littleboot/ACRE/Firmware/Doc/readme.txt

Firmware fot the Absolute Capacitive Rotary Encoder (ACRE).
