littleboot/ACRE/docs/images/capacitors_plates_figure.png

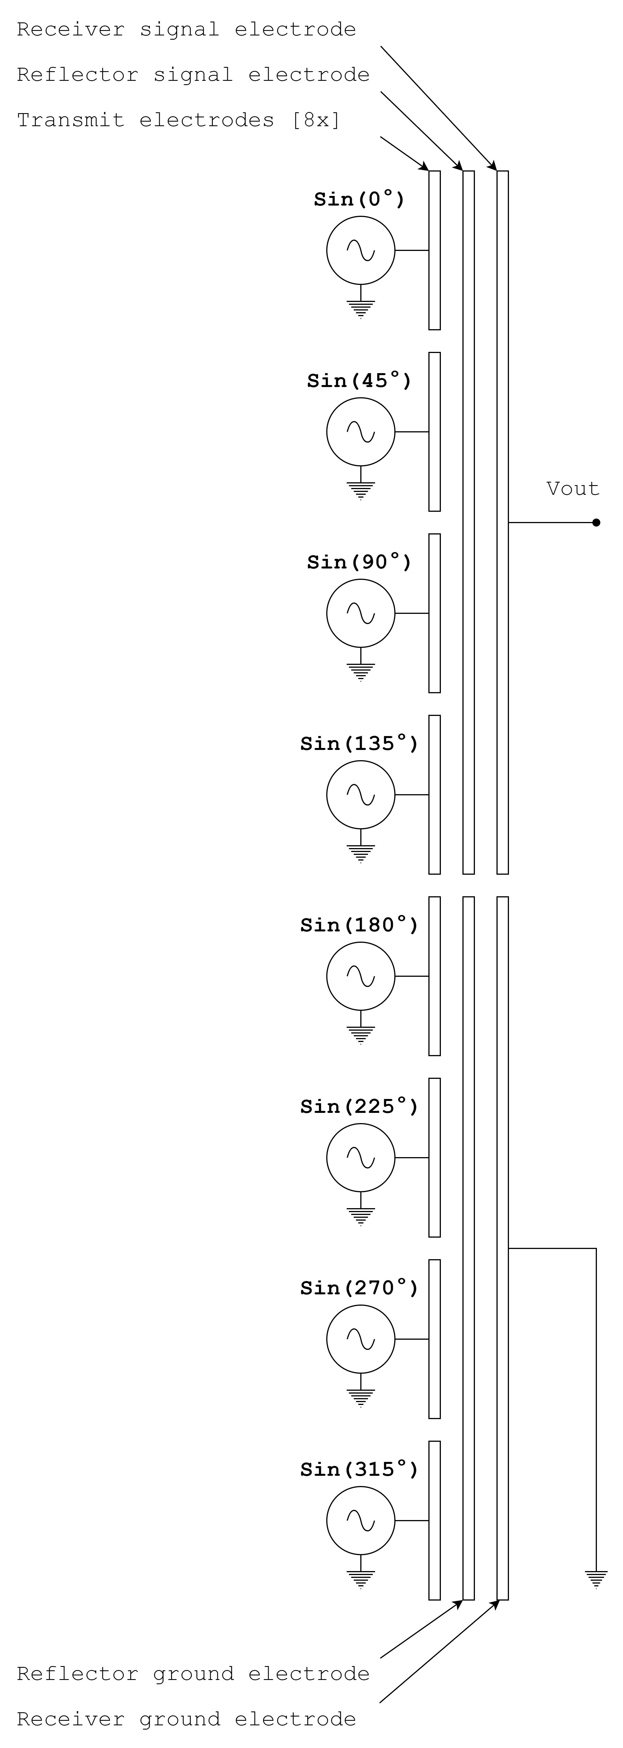
docs/images/capacitors_plates_figure.png
