littleboot/ACRE/docs/images/gif_animation_sources/1.png

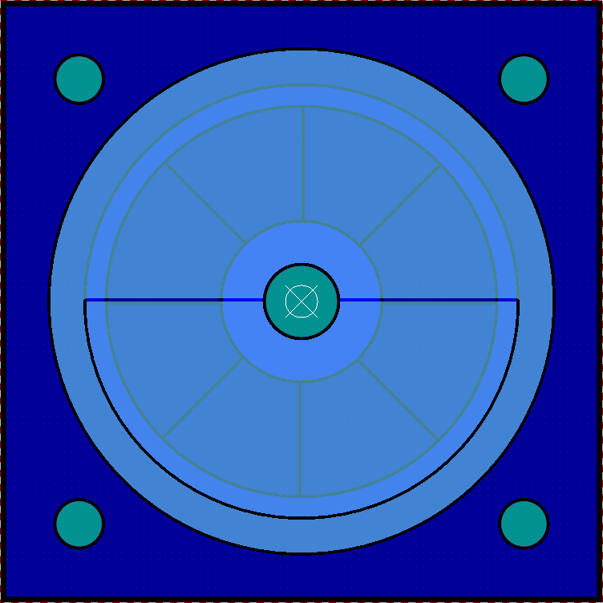
docs/images/gif_animation_sources/1.png
