littleboot/ACRE/docs/images/gif_animation_sources/3.png

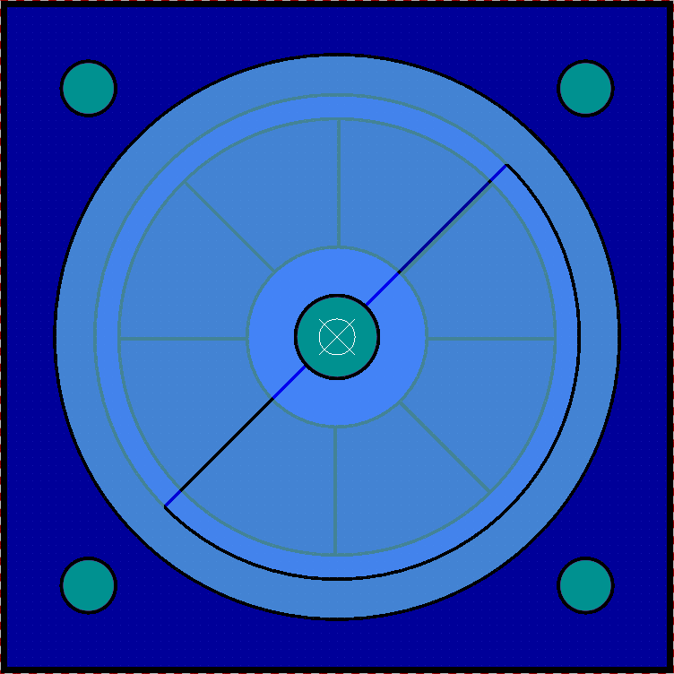
docs/images/gif_animation_sources/3.png
