littleboot/ACRE/docs/images/gif_animation_sources/4.png

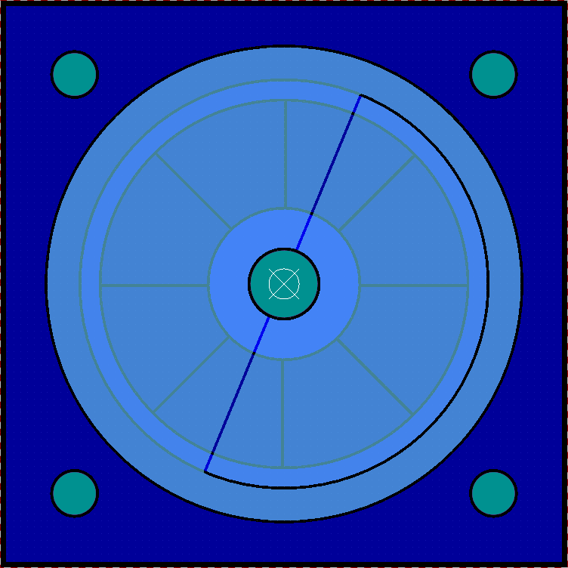
docs/images/gif_animation_sources/4.png
