littleboot/ACRE/docs/images/gif_animation_sources/5.png

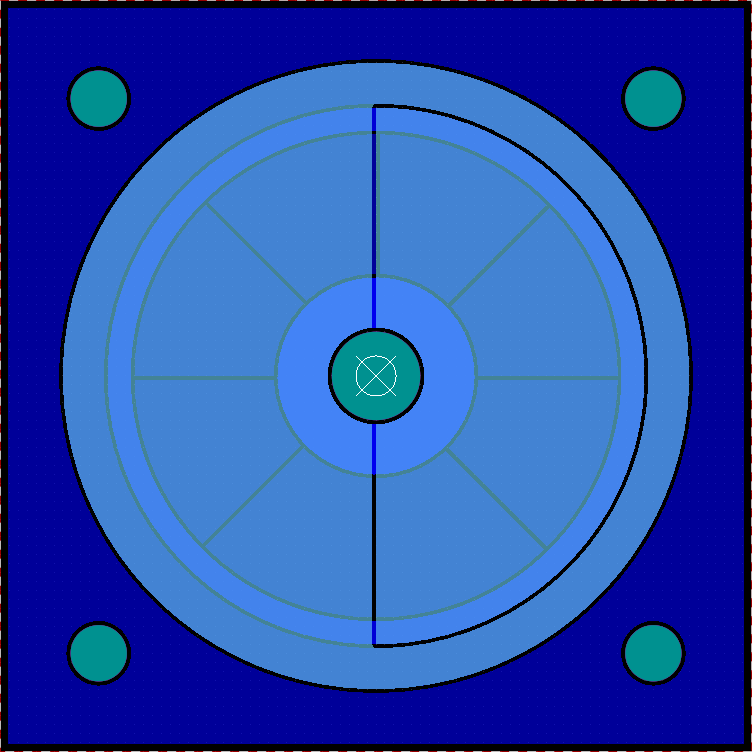
docs/images/gif_animation_sources/5.png
