littleboot/ACRE/docs/images/gif_animation_sources/6.png

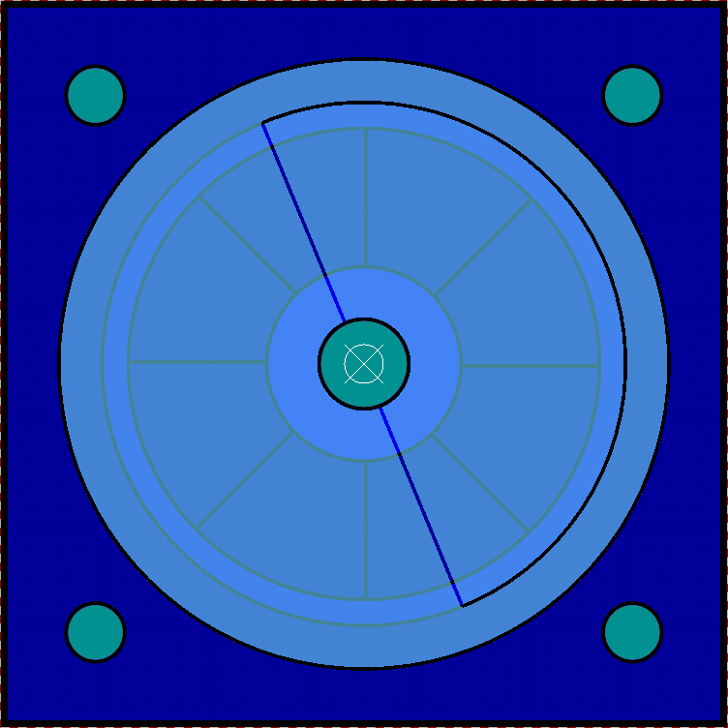
docs/images/gif_animation_sources/6.png
