littleboot/ACRE/docs/images/gif_animation_sources/7.png

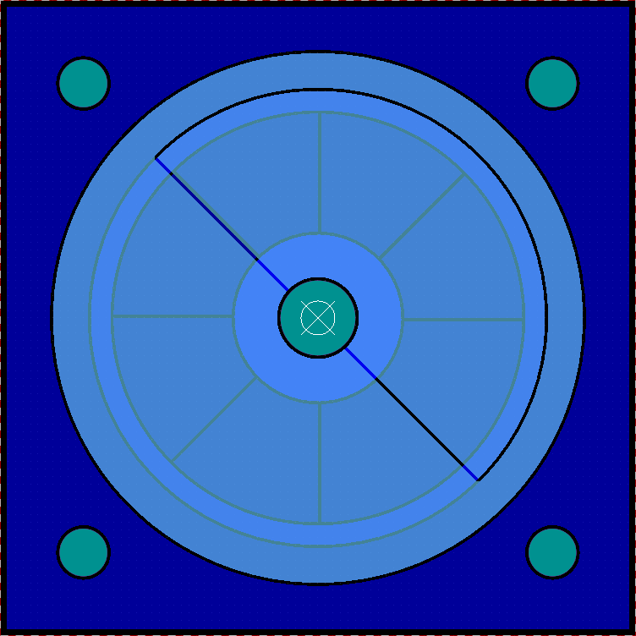
docs/images/gif_animation_sources/7.png
