littleboot/ACRE/docs/images/gif_animation_sources/9.png

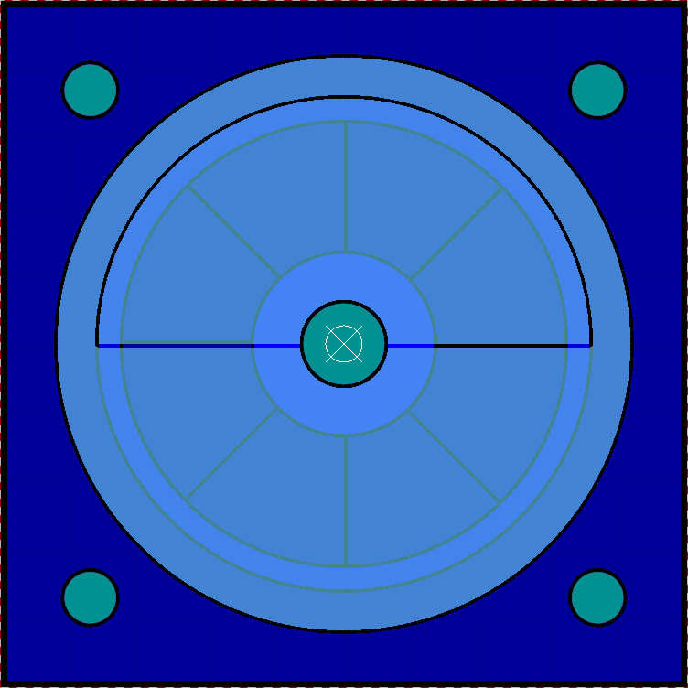
docs/images/gif_animation_sources/9.png
