littleboot/ACRE/docs/images/gif_animation_sources/12.png

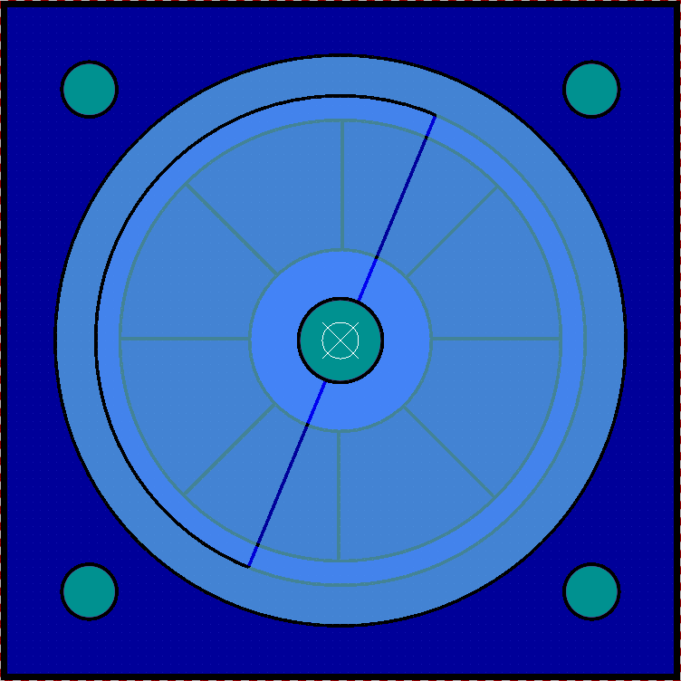
docs/images/gif_animation_sources/12.png
