littleboot/ACRE/docs/images/gif_animation_sources/13.png

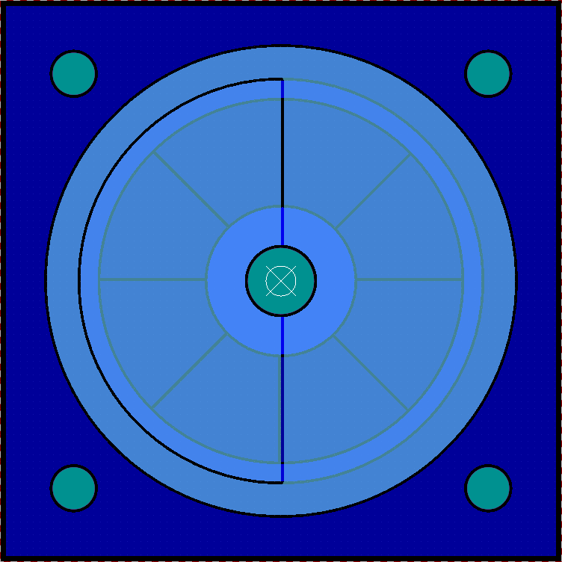
docs/images/gif_animation_sources/13.png
