littleboot/ACRE/docs/images/gif_animation_sources/14.png

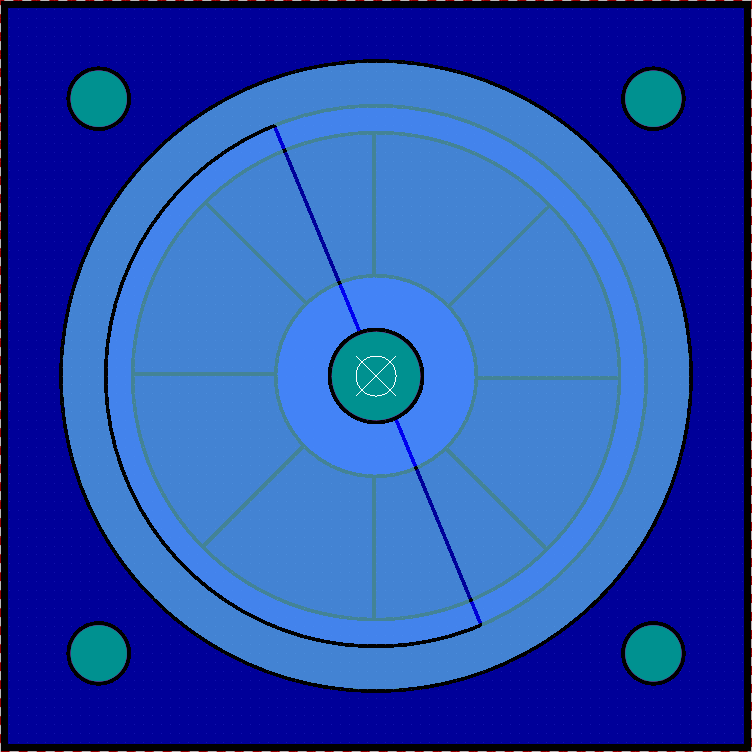
docs/images/gif_animation_sources/14.png
