littleboot/ACRE/docs/images/gif_animation_sources/a1.png

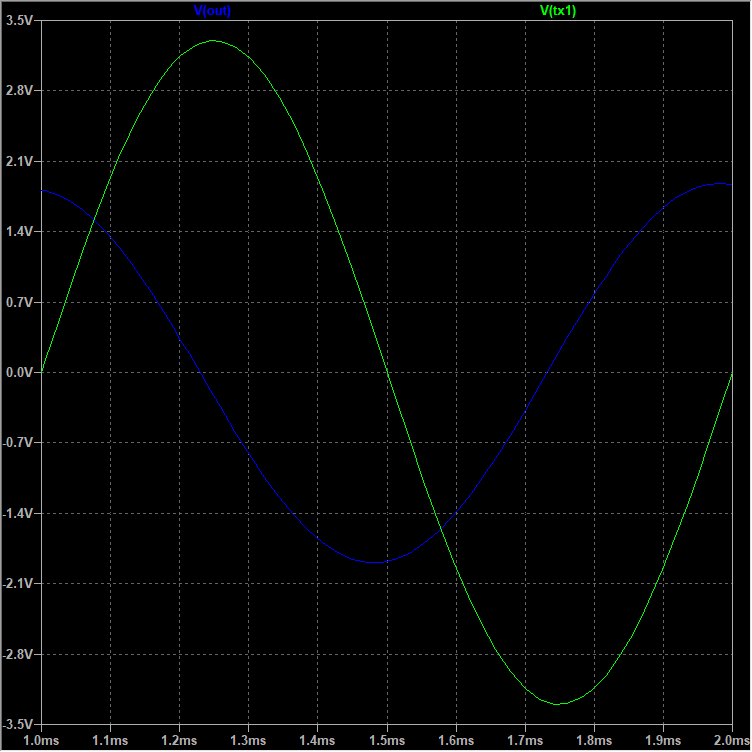
docs/images/gif_animation_sources/a1.png
