littleboot/ACRE/docs/images/gif_animation_sources/a7.png

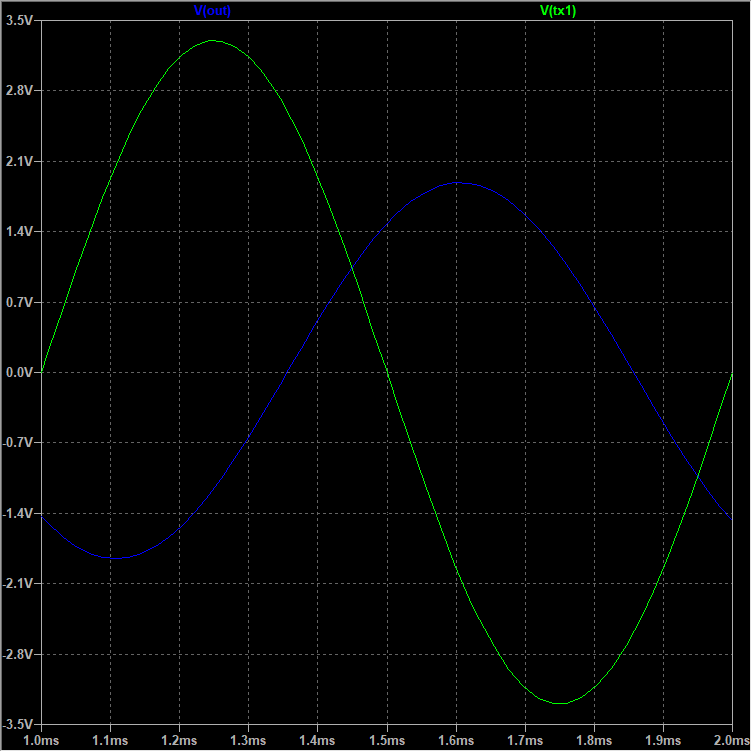
docs/images/gif_animation_sources/a7.png
