littleboot/ACRE/docs/images/gif_animation_sources/a15.png

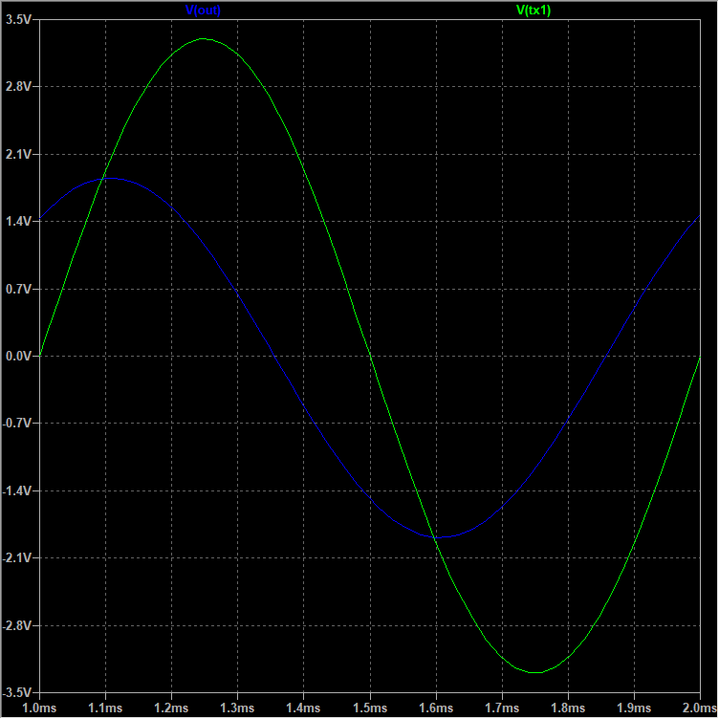
docs/images/gif_animation_sources/a15.png
