littleboot/ACRE/docs/images/gif_animation_sources/b5.png

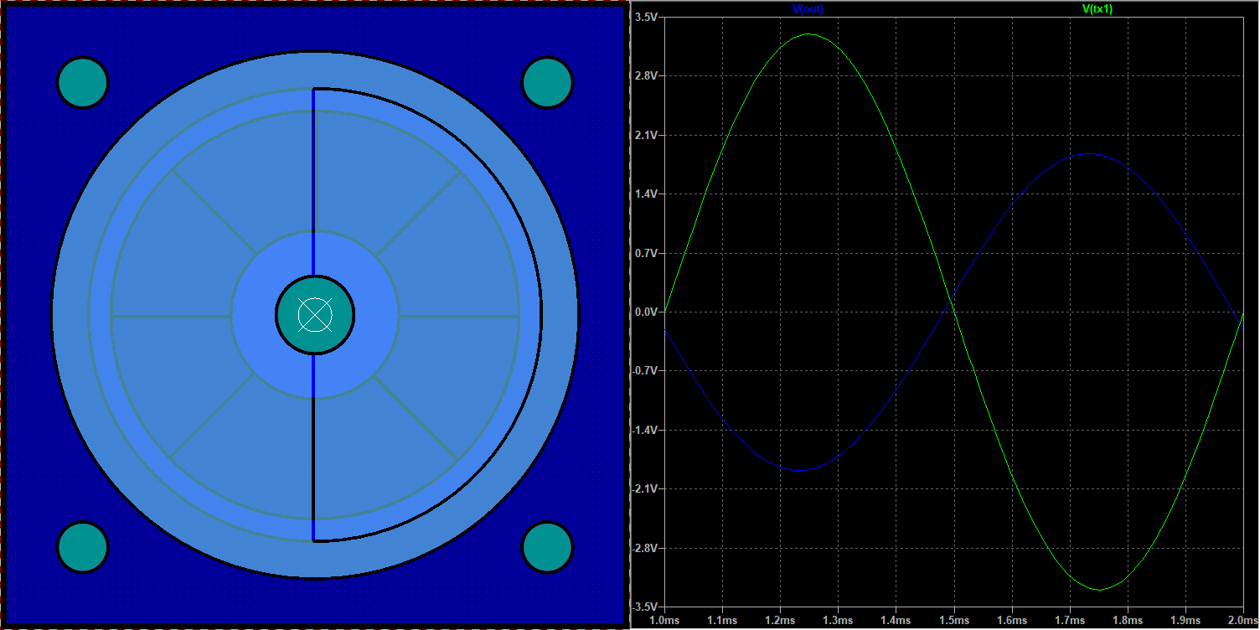
docs/images/gif_animation_sources/b5.png
