littleboot/ACRE/docs/images/Scope_signals01.png

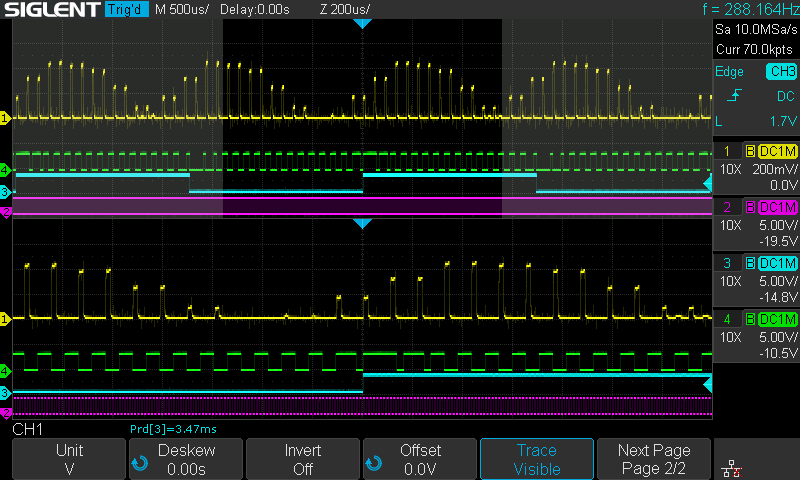
docs/images/Scope_signals01.png
