littleboot/ACRE/docs/images/sine_addition_SPICE_plot.png

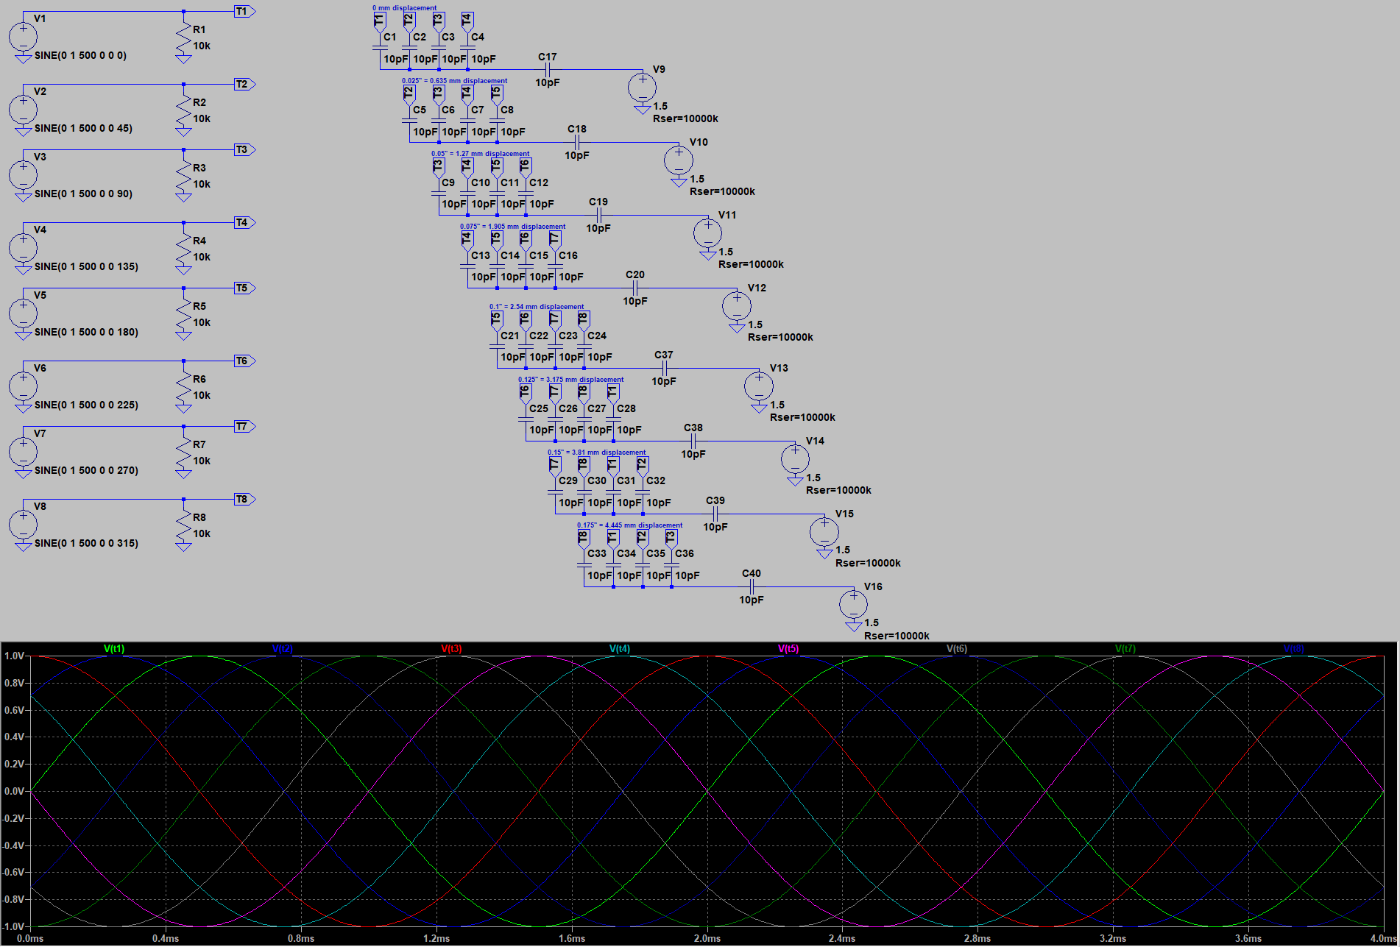
docs/images/sine_addition_SPICE_plot.png
