littleboot/ACRE/Hardware/Electrical/T211110V01/_Ordered/Readme.txt

This folder contains fabrication files and BOM's that have been ordered in the past
