littleboot/ACRE/Hardware/Electrical/T211110V01/_Ordered/T211110V01 2021-11-16/Documentation - T211110V01 2021-11-16/BOM - T211110V01 2021-11-16  23-40.xlsx

Sheet: BOM - T211110V01 2021-11-16 23
Designator | Comment | Description | Part Number | Manufacturer | Footprint | Supplier 1 | Supplier Part Number 1 | Supplier 2 | Supplier Part Number 2 | Supplier 3 | Supplier Part Number 3 | Quantity
C1, C3, C22 | 10uF | 10uF ±10% 25V X5R 1206 Multilayer Ceramic Capacitors MLCC - SMD/SMT RoHS | CL31A106KAHNNNE | SAMSUNG | CAP 1206 3216 IPC MEDIUM | LCSC | C9807 | Farnell | 3013511 | Mouser | 187-CL31A106KAHNNNE | 3 | 15
C2, C4, C7, C11, C12, C14, C16, C21, C23, C26 | 100nF | 100nF ±10% 50V X7R 0603 Multilayer Ceramic Capacitors MLCC - SMD/SMT RoHS | C0603B104K500NT | TORCH | CAP 0603 1608 IPC MEDIUM | LCSC | C478888 |  |  |  |  | 10 | 50
C5, C8 | 1uF | Generic 0603 1608 Capacitor | CGA3E1X7R1C105M080AC | TDK | CAP 0603 1608 IPC MEDIUM | Farnell | 2768390 |  |  |  |  | 2 | 10
C6, C13 | 4.7uF | 4.7 µF, 25 V, 0603 [1608 Metric], ± 10%, X5R, GRM Series | GRM188R61E475KE11D | MURATA | CAP 0603 1608 IPC MEDIUM | Farnell | 2426959 |  |  |  |  | 2 | 10
C9 | 10nF | Generic 0603 1608 Capacitor | x |  | CAP 0603 1608 IPC MEDIUM | Farnell | 2495178 |  |  |  |  | 1 | 5
C10, C15 | open | Capacitor 0603 1608 value undefined | x |  | CAP 0603 1608 IPC MEDIUM |  |  |  |  |  |  | 2 | 10
C17, C18, C19, C20 | 12pF | 12pF ±5% 50V NP0 0603 Multilayer Ceramic Capacitors MLCC - SMD/SMT RoHS | CC0603JRNPO9BN120 | YAGEO | CAP 0603 1608 IPC MEDIUM | LCSC | C107034 | Farnell | 721979 | Mouser | 603-CC603JRNPO9BN120 | 4 | 20
C24, C25 | 330pF | Generic 0603 1608 Capacitor | CL10C331JB8NNNC | SAMSUNG | CAP 0603 1608 IPC MEDIUM | LCSC | C1664 | Mouser | 187-CL10C331JB8NNNC | Digikey | 1276-1073-1-ND | 2 | 10
C27 | 47pF | Generic 0603 1608 Capacitor | x |  | CAP 0603 1608 IPC MEDIUM |  |  |  |  |  |  | 1 | 5
D1, D2, D3 | 19-217/R6C-AL1M2VY/3T | Red 617.5~633.5nm 0603 Light Emitting Diodes (LED) RoHS | 19-217/R6C-AL1M2VY/3T | EVERLIGHT | 19-217 - EVERLIGHT | LCSC | C72044 |  |  |  |  | 3 | 15
D4 | RCLAMP0524P-N | TVS ARRAY, 40W, 5V, UNIDIRECTIONAL, USB, HDMI | RCLAMP0524P-N | BORN | RCLAMP0524P-N - BORN | LCSC | C316044 |  |  |  |  | 1 | 5
FB1 | 600 E @ 100 MHz | Ferrite Bead, 0603 [1608 Metric], 600 ohm, 500 mA, BLM18A Series, 0.38 ohm, ± 25% | BLM18AG601SN1D | MURATA | FB 0603 1608 IPC MEDIUM - Murata | Farnell | 1515679 | Mouser | 81-BLM11A601S | LCSC | C19330 | 1 | 5
J1 | TYPE-C-31-M-12 | USB - Type C Female 12-pin | TYPE-C-31-M-12 | HRO ELECTRONICS | TYPE-C-31-M-12 - KOREAN HROPARTS ELEC | LCSC | C165948 |  |  |  |  | 1 | 5
Q1 | 2N7002AK | Power MOSFET, N Channel, 60 V, 190 mA, 3 ohm, SOT-23 TO-236AB | 2N7002AK | NEXPERIA | SOT23-3 IPC MEDIUM - NEXPERIA | Farnell | 2191746 | Mouser | 771-NX7002AK,215 | LCSC | C255584 | 1 | 5
R1, R2, R3, R5 | 1K | 1kΩ ±1% 0.1W ±100ppm/℃ 0603 Chip Resistor - Surface Mount RoHS | RC0603FR-071KL | YAGEO | RES 0603 1608 IPC MEDIUM | LCSC | C22548 | Farnell | 2421849 | Mouser | 603-RC0603FR-071KL | 4 | 20
R4 | 2K | 2kΩ ±1% 0.1W 0603 Chip Resistor - Surface Mount RoHS | RMC06032K1%N | TOYOHM | RES 0603 1608 IPC MEDIUM | LCSC | C269421 |  |  |  |  | 1 | 5
R6 | 47K | 47kΩ ±1% 100mW ±100ppm/℃ Thick Film Resistors 75V -55℃~+155℃ 0603 Chip Resistor - Surface Mount RoHS | RC0603FR-0747KL | YAGEO | RES 0603 1608 IPC MEDIUM | LCSC | C105579 | Farnell | 2421877 | Mouser | 603-RC0603FR-0747KL | 1 | 5
R7, R8, R9, R10 | 10K | 10kΩ ±1% 0.1W ±100ppm/℃ 0603 Chip Resistor - Surface Mount RoHS | RC0603FR-0710KL | YAGEO | RES 0603 1608 IPC MEDIUM | LCSC | C98220 | Farnell | 2421850 | Digikey | 311-10.0KHRCT-ND | 4 | 20
R11, R12, R16 | 100E | 100Ω ±1.0% 1/10W ±100ppm/℃ Thick Film Resistors 75V -55℃~+155℃ 0603 Chip Resistor - Surface Mount RoHS | RC0603FR-07100RL | YAGEO | RES 0603 1608 IPC MEDIUM | LCSC | C105588 | Farnell | 2421848 | Mouser | 603-RC0603FR-07100RL | 3 | 15
R13, R14 | 5.1K | 5.1kΩ ±1% 0.1W 0603 Chip Resistor - Surface Mount RoHS | RMC06035.1K1%N | TYOHM | RES 0603 1608 IPC MEDIUM | LCSC | C269716 |  |  |  |  | 2 | 10
R15 | 0E | 0Ω ±1.0% 1/10W Thick Film Resistors 75V -55℃~+155℃ 0603 Chip Resistor - Surface Mount RoHS | RC0603FR-070RL | YAGEO | RES 0603 1608 IPC MEDIUM | LCSC | C100044 | Farnell | 2309106 | Mouser | 603-RC0603FR-070RL | 1 | 5
U1 | AMS1117-3.3 | LDO 3.3V 1A 18V | AMS1117-3.3 | UMW | SOT223 IPC MEDIUM - UMW | LCSC | C347222 |  |  |  |  | 1 | 5
U2 | MCP6001T-I/OT | Operational Amplifier, Single, 1 Amplifier, 1 MHz, 0.6 V/µs, 1.8V to 6V, SOT-23, 5 Pins | MCP6001T-I/OT | MICROCHIP | SOT23-5 IPC MEDIUM - MICROCHIP | Farnell | 4974992 | LCSC | C116490 | - |  | 1 | 5
U3 | STM32F103C8T6 | ARM Microcontroller, Motor Control, STM32 Family STM32F1 Series Microcontrollers, ARM Cortex-M3 | STM32F103C8T6 | STMICROELECTRONICS | LQFP48 IPC MEDIUM - STMICROELECTRONICS | Farnell | 1447637 | Mouser | 511-STM32F103C8T6 | LCSC | C8734 | 1 | 5
U4 | 74HC1G66GV | Analogue Switch, SPST, 1 Channels, 50 ohm, 2V to 9V, TSOP, 5 Pins | 74HC1G66GV | NEXPERIA | SOT753 IPC MEDIUM - NEXPERIA | LCSC | 74HC1G66GV | Farnell | 2777726 | Mouser | 771-HC1G66GV125 | 1 | 5
U5 | CH340T | USB to UART Bridge Controller USB 2.0 Full speed 50bps to 2Mbps | CH340T | WCH | CH340T - WCH | LCSC | C8689 |  |  |  |  | 1 | 5
X1, X2 | X322512MLB4SI | 12MHz ±10ppm 9pF 80Ω SMD-3225_4P Crystals RoHS | X322512MLB4SI | YXC | X322512MLB4SI - YXC | LCSC | C112971 |  |  |  |  | 2 | 10

Sheet: LCSC Order 5pcs
Designator | Comment | Description | Part Number | Manufacturer | Footprint | Supplier 1 | Supplier Part Number 1 | Supplier 2 | Supplier Part Number 2 | Supplier 3 | Supplier Part Number 3
C1, C3, C22 | 10uF | 10uF ±10% 25V X5R 1206 Multilayer Ceramic Capacitors MLCC - SMD/SMT RoHS | CL31A106KAHNNNE | SAMSUNG | CAP 1206 3216 IPC MEDIUM | LCSC | C9807 | Farnell | 3013511 | Mouser | 187-CL31A106KAHNNNE | 15
C2, C4, C7, C11, C12, C14, C16, C21, C23, C26 | 100nF | 100nF ±10% 50V X7R 0603 Multilayer Ceramic Capacitors MLCC - SMD/SMT RoHS | C0603B104K500NT | TORCH | CAP 0603 1608 IPC MEDIUM | LCSC | C478888 |  |  |  |  | 50
C5, C8 | 1uF | Generic 0603 1608 Capacitor | CGA3E1X7R1C105M080AC | TDK | CAP 0603 1608 IPC MEDIUM | Farnell | 2768390 | LCSC | C1592 |  |  | 10
C6, C13 | 4.7uF | 4.7 µF, 25 V, 0603 [1608 Metric], ± 10%, X5R, GRM Series | GRM188R61E475KE11D | MURATA | CAP 0603 1608 IPC MEDIUM | Farnell | 2426959 | LCSC | C8032 |  |  | 10
C9 | 10nF | Generic 0603 1608 Capacitor | x |  | CAP 0603 1608 IPC MEDIUM | Farnell | 2495178 | LCSC | C100042 |  |  | 5
C10, C15 | open | Capacitor 0603 1608 value undefined | x |  | CAP 0603 1608 IPC MEDIUM |  |  |  |  |  |  | 0
C17, C18, C19, C20 | 12pF | 12pF ±5% 50V NP0 0603 Multilayer Ceramic Capacitors MLCC - SMD/SMT RoHS | CC0603JRNPO9BN120 | YAGEO | CAP 0603 1608 IPC MEDIUM | LCSC | C107034 | Farnell | 721979 | Mouser | 603-CC603JRNPO9BN120 | 20
C24, C25 | 330pF | Generic 0603 1608 Capacitor | CL10C331JB8NNNC | SAMSUNG | CAP 0603 1608 IPC MEDIUM | LCSC | C1664 | Mouser | 187-CL10C331JB8NNNC | Digikey | 1276-1073-1-ND | 10
C27 | 47pF | Generic 0603 1608 Capacitor | x |  | CAP 0603 1608 IPC MEDIUM | LCSC | C105622 |  |  |  |  | 5
D1, D2, D3 | 19-217/R6C-AL1M2VY/3T | Red 617.5~633.5nm 0603 Light Emitting Diodes (LED) RoHS | 19-217/R6C-AL1M2VY/3T | EVERLIGHT | 19-217 - EVERLIGHT | LCSC | C72044 |  |  |  |  | 15
D4 | RCLAMP0524P-N | TVS ARRAY, 40W, 5V, UNIDIRECTIONAL, USB, HDMI | RCLAMP0524P-N | BORN | RCLAMP0524P-N - BORN | LCSC | C316044 |  |  |  |  | 5
FB1 | 600 E @ 100 MHz | Ferrite Bead, 0603 [1608 Metric], 600 ohm, 500 mA, BLM18A Series, 0.38 ohm, ± 25% | BLM18AG601SN1D | MURATA | FB 0603 1608 IPC MEDIUM - Murata | Farnell | 1515679 | Mouser | 81-BLM11A601S | LCSC | C19330 | 5
J1 | TYPE-C-31-M-12 | USB - Type C Female 12-pin | TYPE-C-31-M-12 | HRO ELECTRONICS | TYPE-C-31-M-12 - KOREAN HROPARTS ELEC | LCSC | C165948 |  |  |  |  | 5
Q1 | 2N7002AK | Power MOSFET, N Channel, 60 V, 190 mA, 3 ohm, SOT-23 TO-236AB | 2N7002AK | NEXPERIA | SOT23-3 IPC MEDIUM - NEXPERIA | Farnell | 2191746 | Mouser | 771-NX7002AK,215 | LCSC | C255584 | 5
R1, R2, R3, R5 | 1K | 1kΩ ±1% 0.1W ±100ppm/℃ 0603 Chip Resistor - Surface Mount RoHS | RC0603FR-071KL | YAGEO | RES 0603 1608 IPC MEDIUM | LCSC | C22548 | Farnell | 2421849 | Mouser | 603-RC0603FR-071KL | 20
R4 | 2K | 2kΩ ±1% 0.1W 0603 Chip Resistor - Surface Mount RoHS | RMC06032K1%N | TOYOHM | RES 0603 1608 IPC MEDIUM | LCSC | C269421 |  |  |  |  | 5
R6 | 47K | 47kΩ ±1% 100mW ±100ppm/℃ Thick Film Resistors 75V -55℃~+155℃ 0603 Chip Resistor - Surface Mount RoHS | RC0603FR-0747KL | YAGEO | RES 0603 1608 IPC MEDIUM | LCSC | C105579 | Farnell | 2421877 | Mouser | 603-RC0603FR-0747KL | 5 | *replaced by 10K
R7, R8, R9, R10 | 10K | 10kΩ ±1% 0.1W ±100ppm/℃ 0603 Chip Resistor - Surface Mount RoHS | RC0603FR-0710KL | YAGEO | RES 0603 1608 IPC MEDIUM | LCSC | C98220 | Farnell | 2421850 | Digikey | 311-10.0KHRCT-ND | 20
R11, R12, R16 | 100E | 100Ω ±1.0% 1/10W ±100ppm/℃ Thick Film Resistors 75V -55℃~+155℃ 0603 Chip Resistor - Surface Mount RoHS | RC0603FR-07100RL | YAGEO | RES 0603 1608 IPC MEDIUM | LCSC | C105588 | Farnell | 2421848 | Mouser | 603-RC0603FR-07100RL | 15
R13, R14 | 5.1K | 5.1kΩ ±1% 0.1W 0603 Chip Resistor - Surface Mount RoHS | RMC06035.1K1%N | TYOHM | RES 0603 1608 IPC MEDIUM | LCSC | C269716 |  |  |  |  | 10
R15 | 0E | 0Ω ±1.0% 1/10W Thick Film Resistors 75V -55℃~+155℃ 0603 Chip Resistor - Surface Mount RoHS | RC0603FR-070RL | YAGEO | RES 0603 1608 IPC MEDIUM | LCSC | C100044 | Farnell | 2309106 | Mouser | 603-RC0603FR-070RL | 5
U1 | AMS1117-3.3 | LDO 3.3V 1A 18V | AMS1117-3.3 | UMW | SOT223 IPC MEDIUM - UMW | LCSC | C347222 |  |  |  |  | 5
U2 | MCP6001T-I/OT | Operational Amplifier, Single, 1 Amplifier, 1 MHz, 0.6 V/µs, 1.8V to 6V, SOT-23, 5 Pins | MCP6001T-I/OT | MICROCHIP | SOT23-5 IPC MEDIUM - MICROCHIP | Farnell | 4974992 | LCSC | C116490 | - |  | 5
U3 | STM32F103C8T6 | ARM Microcontroller, Motor Control, STM32 Family STM32F1 Series Microcontrollers, ARM Cortex-M3 | STM32F103C8T6 | STMICROELECTRONICS | LQFP48 IPC MEDIUM - STMICROELECTRONICS | Farnell | 1447637 | Mouser | 511-STM32F103C8T6 | LCSC | C8734 | 5 | Ordered 1 stm32 and rest Gigadevice alternatives
U4 | 74HC1G66GV | Analogue Switch, SPST, 1 Channels, 50 ohm, 2V to 9V, TSOP, 5 Pins | 74HC1G66GV | NEXPERIA | SOT753 IPC MEDIUM - NEXPERIA | LCSC | C89412 | Farnell | 2777726 | Mouser | 771-HC1G66GV125 | 5
U5 | CH340T | USB to UART Bridge Controller USB 2.0 Full speed 50bps to 2Mbps | CH340T | WCH | CH340T - WCH | LCSC | C8689 |  |  |  |  | 5
X1, X2 | X322512MLB4SI | 12MHz ±10ppm 9pF 80Ω SMD-3225_4P Crystals RoHS | X322512MLB4SI | YXC | X322512MLB4SI - YXC | LCSC | C112971 |  |  |  |  | 10
