littleboot/ACRE/docs/images/Assembly_photo01.png

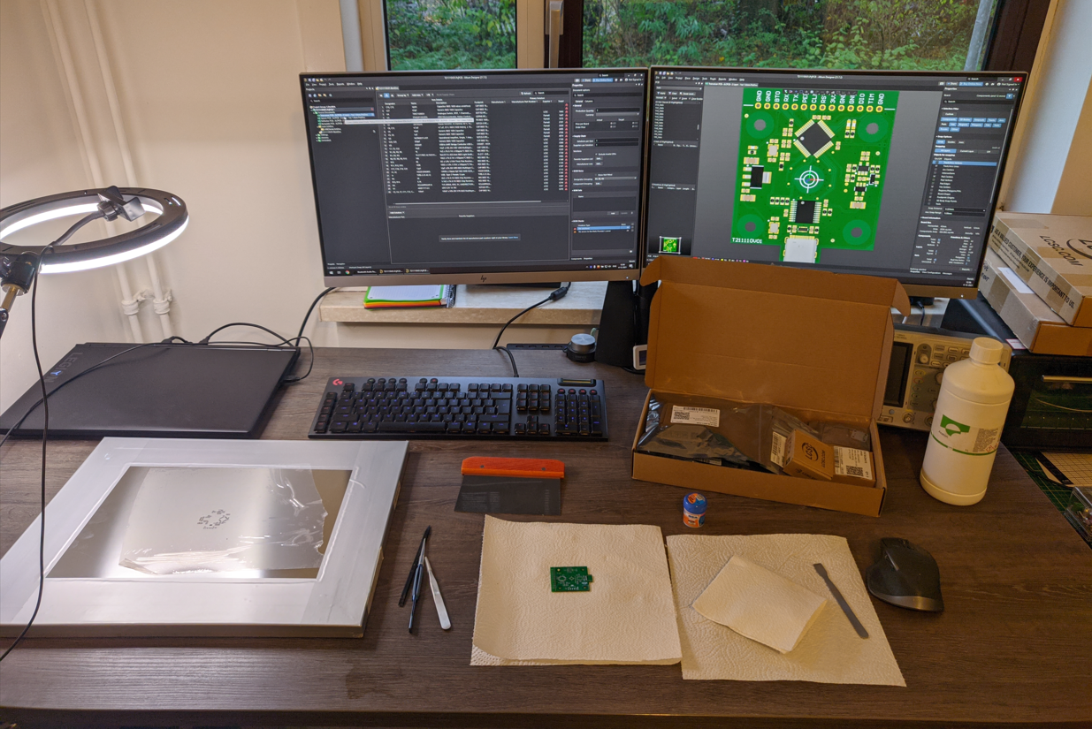
docs/images/Assembly_photo01.png
