littleboot/ACRE/docs/images/thumbnails/Capacitive_absolute_encoder_manual_assembly.png

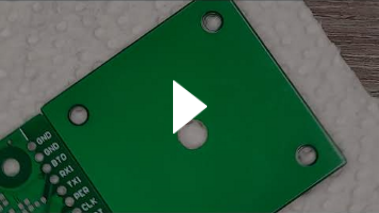
docs/images/thumbnails/Capacitive_absolute_encoder_manual_assembly.png
