littleboot/ACRE/Hardware/Electrical/T211110V01/_Ordered/T211110V01 2021-11-16/Documentation - T211110V01 2021-11-16/Schematic - T211110V01 2021-11-16  23-39.PDF

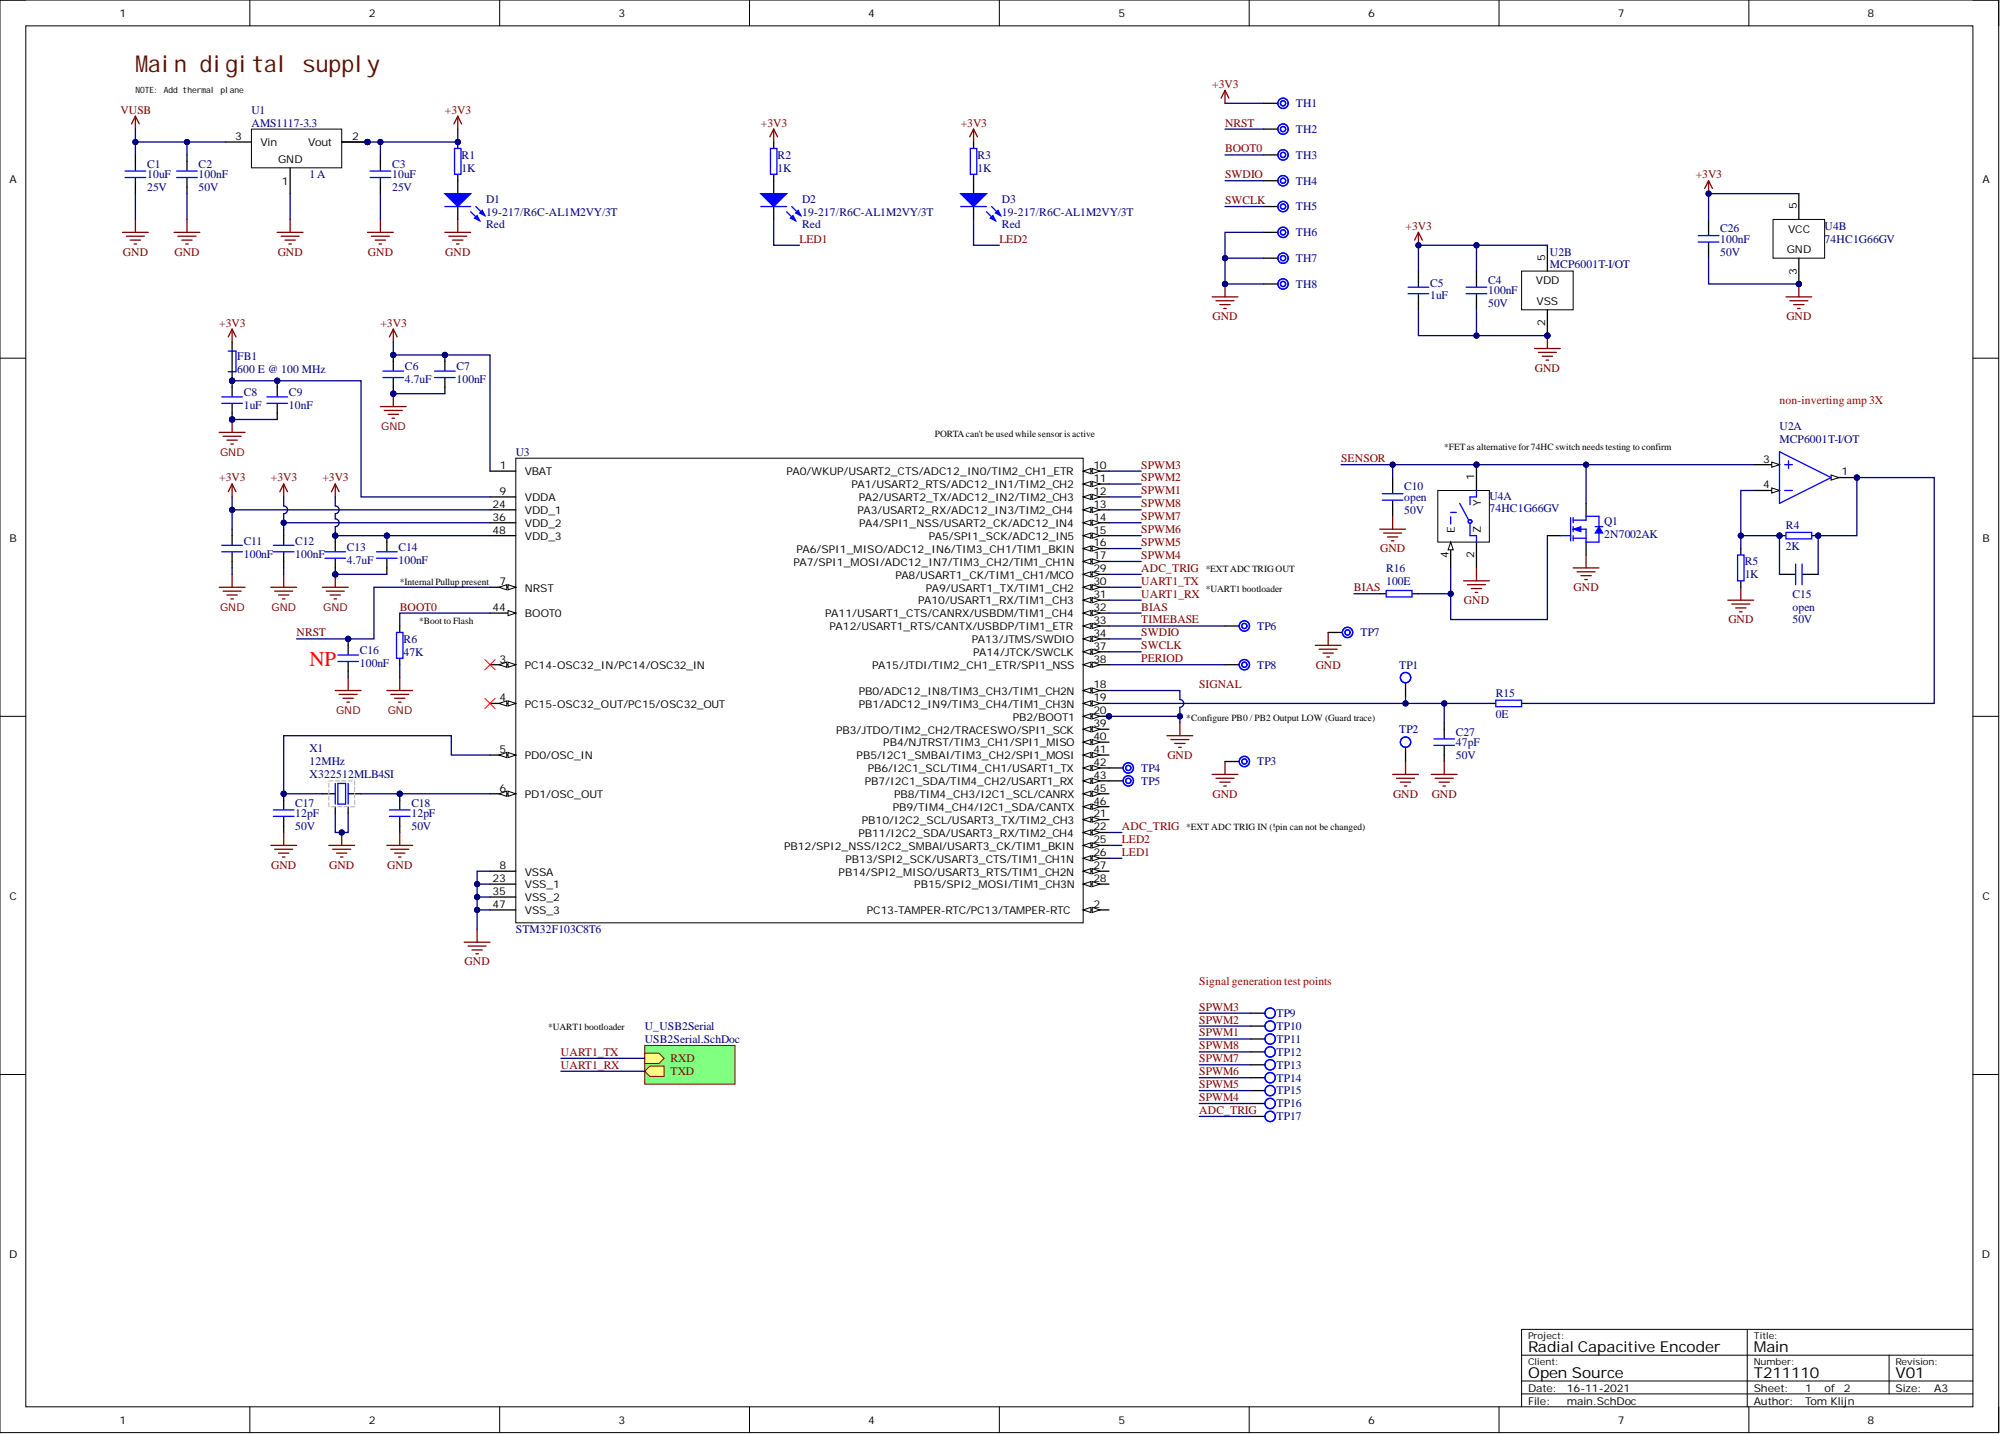
[picture p72: page 1]

Main digital supply GND 25V

NOTE: Add thermal plane

2 4
3 6
4 8

1 9
2 0

Open Source Radial Capacitive Encoder Project:

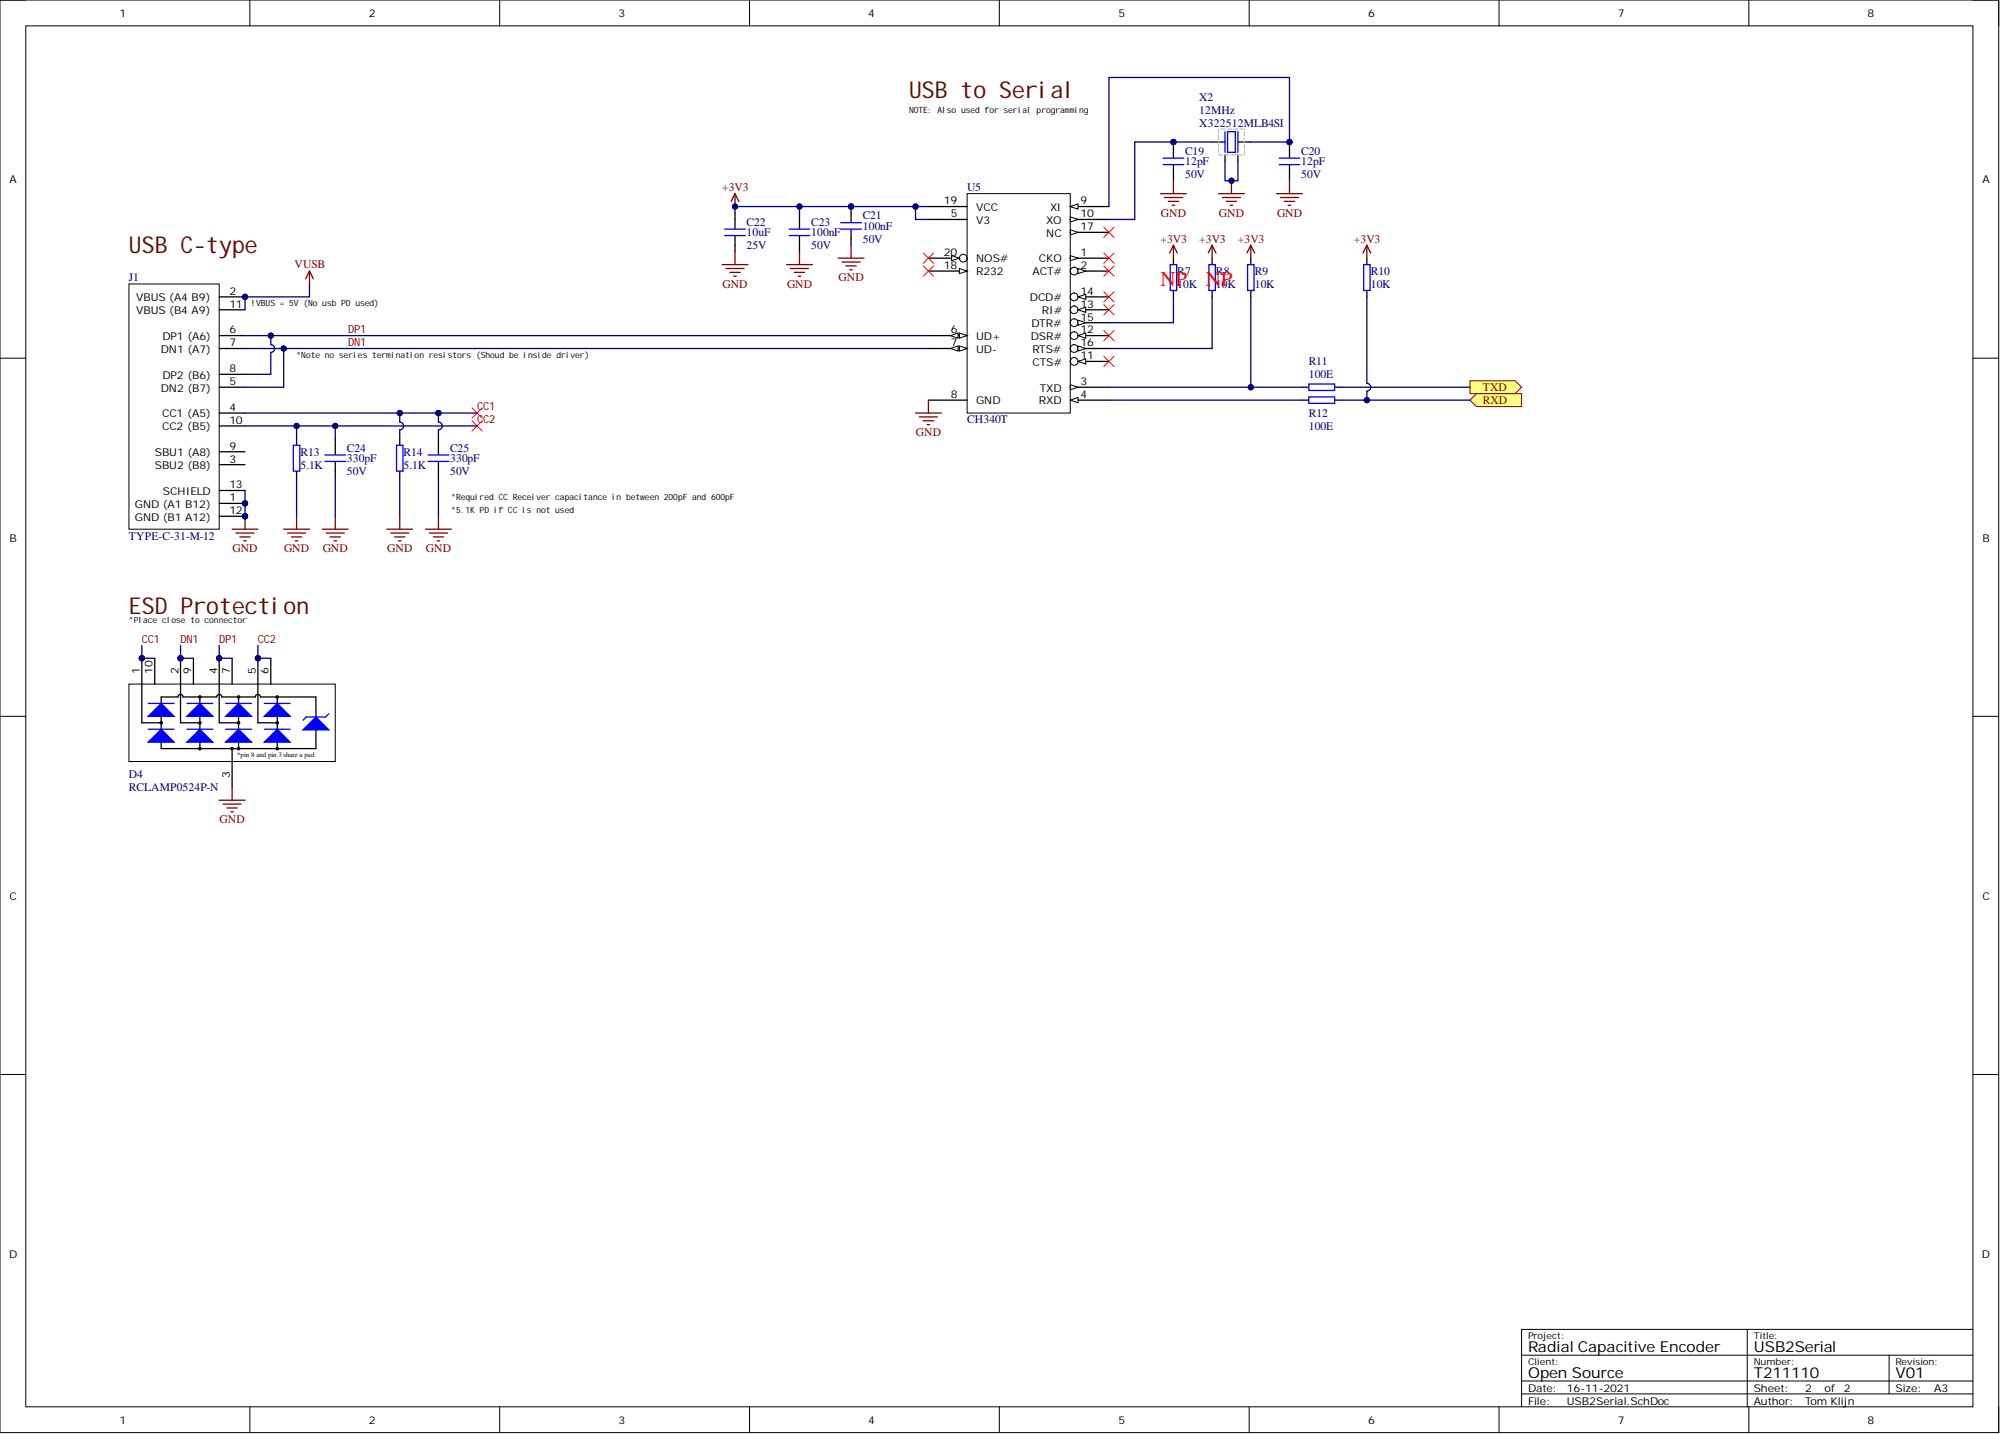
[picture p73: page 2]

NOTE: Also used for serial programming

!VBUS = 5V (No usb PD used)

*Note no series termination resistors (Shoud be inside driver)

*Required CC Receiver capacitance in between 200pF and 600pF
*5.1K PD if CC is not used

*Place close to connector

*pin 8 and pin 3 share a pad
