littleboot/ACRE/docs/images/gif_animation_sources/dispSensSim.asc

C1: cap; {CTX1}
C2: cap; {CTX2}
C3: cap; {CTX3}
C4: cap; {CTX4}
C5: cap; {CTX5}
C6: cap; {CTX6}
C7: cap; {CTX7}
C8: cap; {CTX8}
C9: cap; 100p
R1: res; 10Meg
V1: voltage; SINE(0 {Vtx} 1000 0 0 0)
V2: voltage; SINE(0 {Vtx} 1000 0 0 45)
V3: voltage; SINE(0 {Vtx} 1000 0 0 90)
V4: voltage; SINE(0 {Vtx} 1000 0 0 135)
V5: voltage; SINE(0 {Vtx} 1000 0 0 180)
V6: voltage; SINE(0 {Vtx} 1000 0 0 225)
V7: voltage; SINE(0 {Vtx} 1000 0 0 270)
V8: voltage; SINE(0 {Vtx} 1000 0 0 315)
Named nets: 0, TX1, TX2, TX3, TX4, TX5, TX6, TX7, TX8, OUT
.tran 0 0.002 0
.param Vtx=3.3
.step param index list 1 2 3 4 5 6 7 8 9 10 11 12 13 14 15 16
 
.param CTX1 table(index,1,10p,2,05p,3,00p,4,00p,5,00p,6,00p,7,00p,8,00p,9,00p,10,05p,11,10p,12,10p,13,10p,14,10p,15,10p,16,10p
.param CTX2 table(index,1,10p,2,10p,3,10p,4,05p,5,00p,6,00p,7,00p,8,00p,9,00p,10,00p,11,00p,12,05p,13,10p,14,10p,15,10p,16,10p
.param CTX3 table(index,1,10p,2,10p,3,10p,4,10p,5,10p,6,05p,7,00p,8,00p,9,00p,10,00p,11,00p,12,00p,13,00p,14,05p,15,10p,16,10p
.param CTX4 table(index,1,10p,2,10p,3,10p,4,10p,5,10p,6,10p,7,10p,8,05p,9,00p,10,00p,11,00p,12,00p,13,00p,14,00p,15,00p,16,05p
.param CTX5 table(index,1,00p,2,05p,3,10p,4,10p,5,10p,6,10p,7,10p,8,10p,9,10p,10,05p,11,00p,12,00p,13,00p,14,00p,15,00p,16,00p
.param CTX6 table(index,1,00p,2,00p,3,00p,4,05p,5,10p,6,10p,7,10p,8,10p,9,10p,10,10p,11,10p,12,05p,13,00p,14,00p,15,00p,16,00p
.param CTX7 table(index,1,00p,2,00p,3,00p,4,00p,5,00p,6,05p,7,10p,8,10p,9,10p,10,10p,11,10p,12,10p,13,10p,14,05p,15,00p,16,00p
.param CTX8 table(index,1,00p,2,00p,3,00p,4,00p,5,00p,6,00p,7,00p,8,05p,9,10p,10,10p,11,10p,12,10p,13,10p,14,10p,15,10p,16,05p
