littleboot/ACRE/(list of files, drawings)

Other design files:
docs/images/gif_animation_sources/electrodes_only.PcbDoc
Hardware/Electrical/T211110V01/Boards/Backplate PCB - JLCPCB - 2 Layer - 1oz 1.6mm.PcbDoc
Hardware/Electrical/T211110V01/Boards/Spacer PCB - JLCPCB - 2 Layer - 1oz 1.6mm.PcbDoc
Hardware/Electrical/T211110V01/T211110V01.PrjPCB
Hardware/Electrical/T211110V02/Boards/Reflector PCB - JLCPCB - 2 Layer - 1oz 1.6mm.PcbDoc
Hardware/Electrical/T211110V02/Boards/Tranceiver PCB - JLCPCB - 2 Layer - 1oz 1.6mm.PcbDoc
Hardware/Electrical/T211110V02/Schematics/main.SchDoc
Hardware/Electrical/T211110V02/Schematics/USB2Serial.SchDoc
Hardware/Electrical/T211110V02/T211110V02.PrjPCB
