littleboot/ACRE/Firmware/Include/i2c.h

#ifdef __cplusplus
extern "C"
{
#endif

#ifndef I2C_H
#define I2C_H

/* ========================== include files =========================== */
/* ============================ constants ============================= */
/* ========================== public data ============================= */

/* ======================= public functions =========================== */
void i2c_config(void);
void i2c_busScan(void);


#endif /* I2C_H */

#ifdef __cplusplus
}
#endif
