littleboot/ACRE/(commit log)

2021-12-20 Initial commit
    All projects files to repo
    [BOM - T211110V01 2021-11-16 23-40.xlsx, Backplate PCB - JLCPCB - 2 Layer - 1oz 1.6mm.PcbDoc, Caliper Signal sample calculation.xlsx, Reflector PCB - JLCPCB - 2 Layer - 1oz 1.6mm.PcbDoc, Spacer PCB - JLCPCB - 2 Layer - 1oz 1.6mm.PcbDoc, T211110V01.PrjPCB, Tranceiver PCB - JLCPCB - 2 Layer - 1oz 1.6mm.PcbDoc, USB2Serial.SchDoc]
2021-12-24 added PCB caliper renders and short description to the readme
2021-12-25 see prev commit
    [BOM - T211110V01 2021-11-16 23-40.xlsx, Reflector PCB - JLCPCB - 2 Layer - 1oz 1.6mm.PcbDoc, T211110V02.PrjPCB, Tranceiver PCB - JLCPCB - 2 Layer - 1oz 1.6mm.PcbDoc, USB2Serial.SchDoc, main.SchDoc]
2021-12-30 Animation of working principle added
    [electrodes_only.PcbDoc]
2022-03-02 Added research documents about capacitive displacement tech
2022-10-31 Added PCB caliper project files (linear encoder schematic/PCB files request Tim)
